tmshlvck/lark-hw/out/lark.pdf

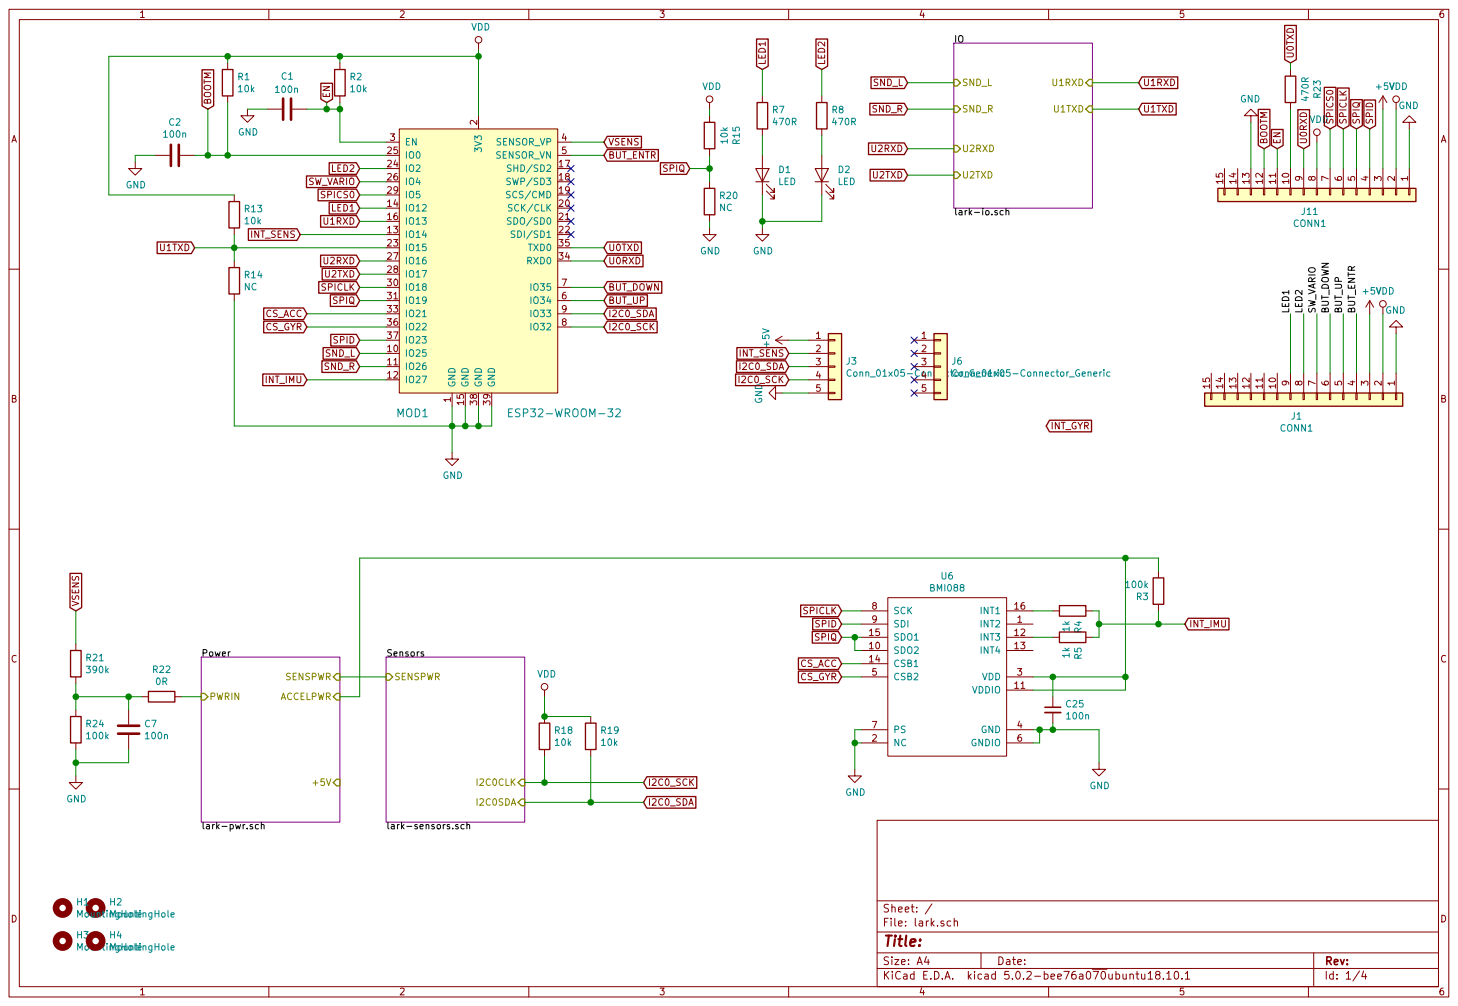
[picture p1: page 1]

2 SCK/CLK 20 SDO/SD0 21 SDI/SD1 22

Id: 1/4 Title: File: lark.sch Sheet: / GND

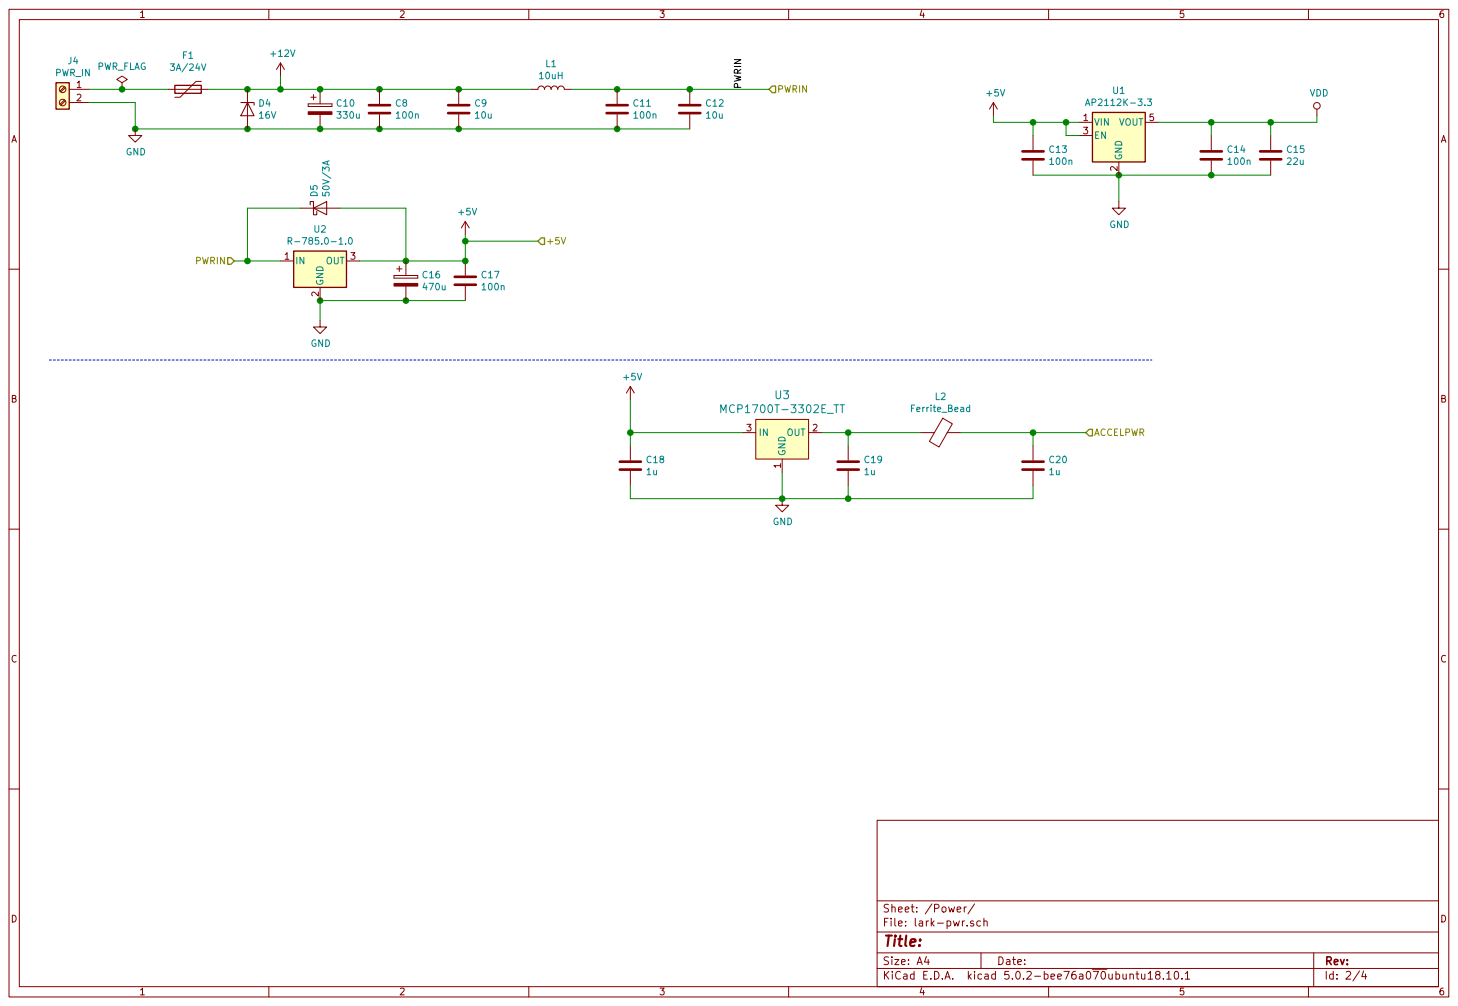
[picture p2: page 2]

File: lark-pwr.sch Sheet: /Power/
Id: 2/4 Title:

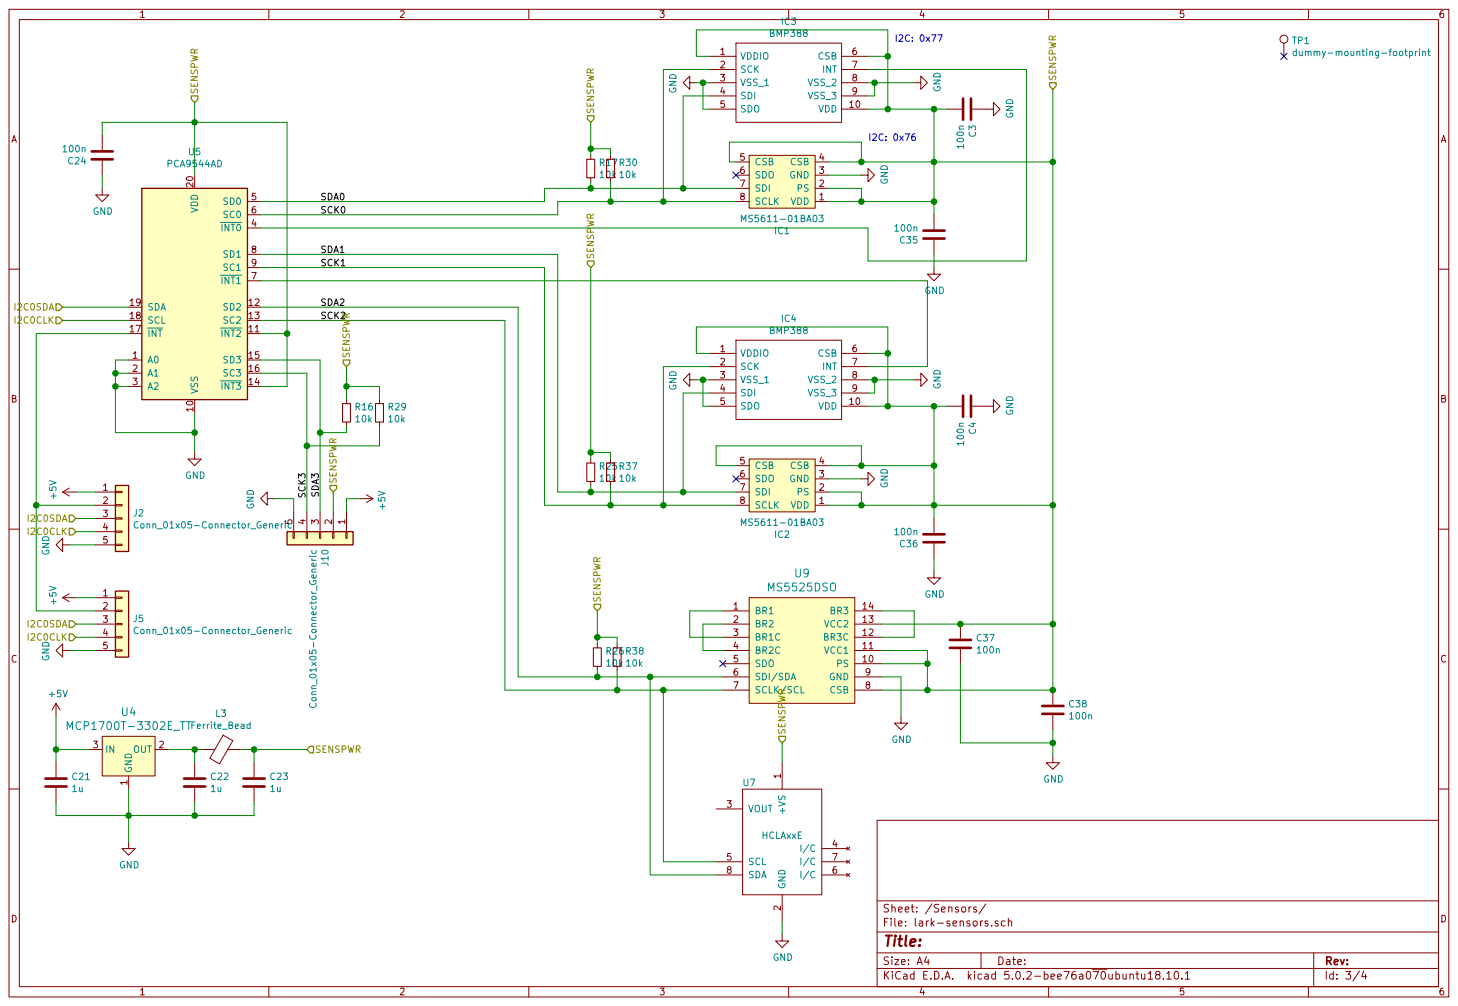
[picture p3: page 3]

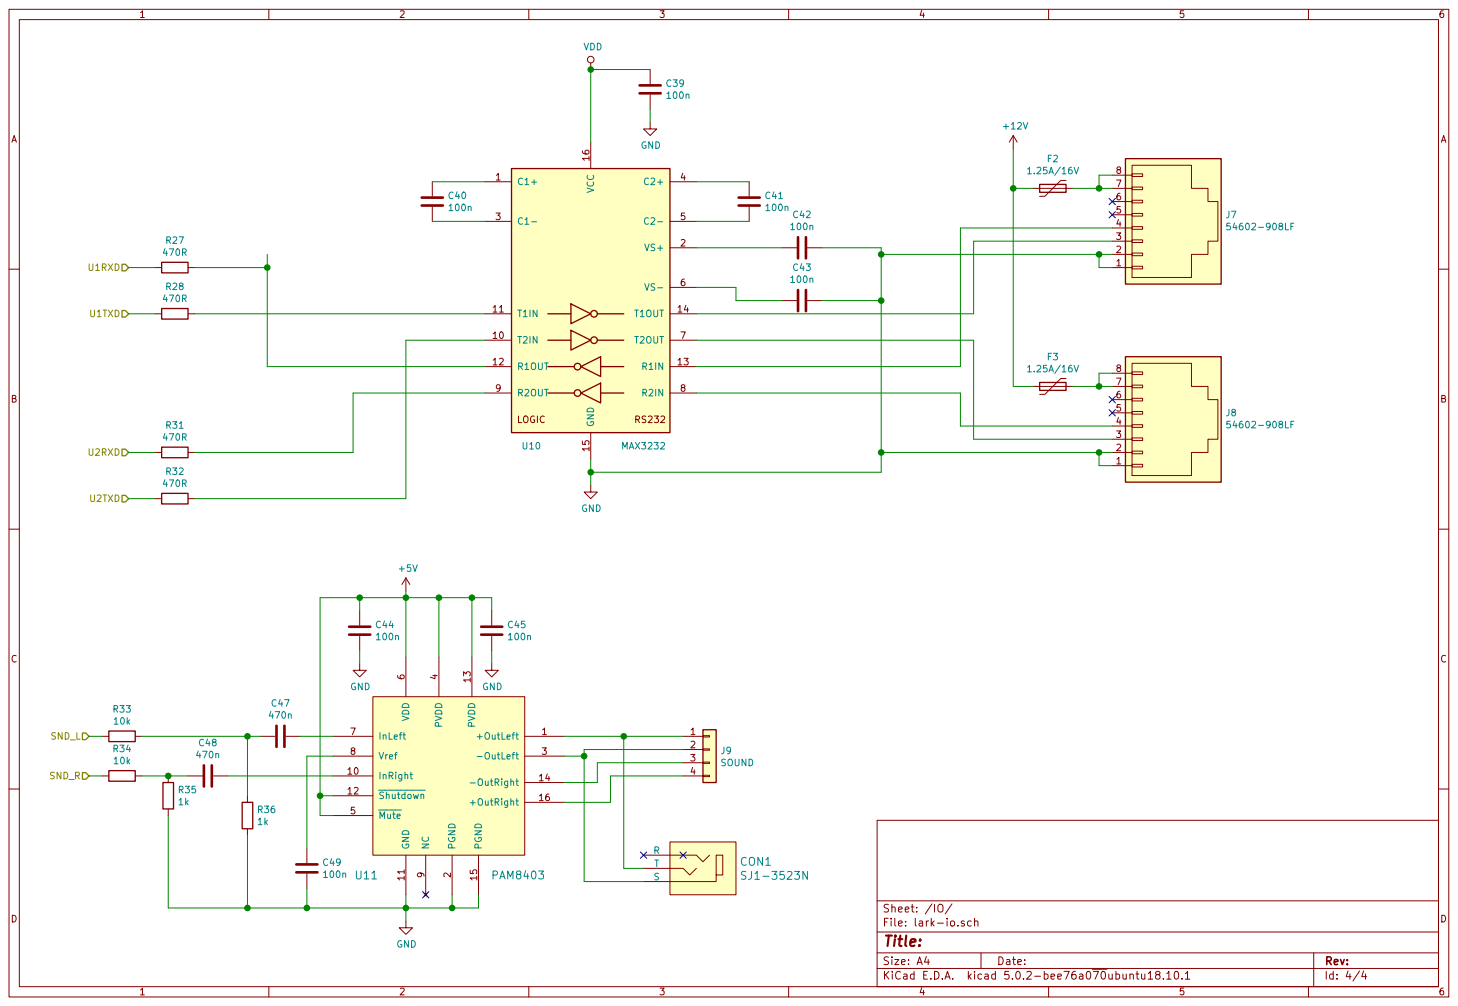
[picture p4: page 4]

Id: 4/4 Title: File: lark-io.sch Sheet: /IO/ SND_L SND_R
