tmshlvck/lark-hw/lark.kicad_pcb

## KiCad design lark.kicad_pcb (2019-03-14)

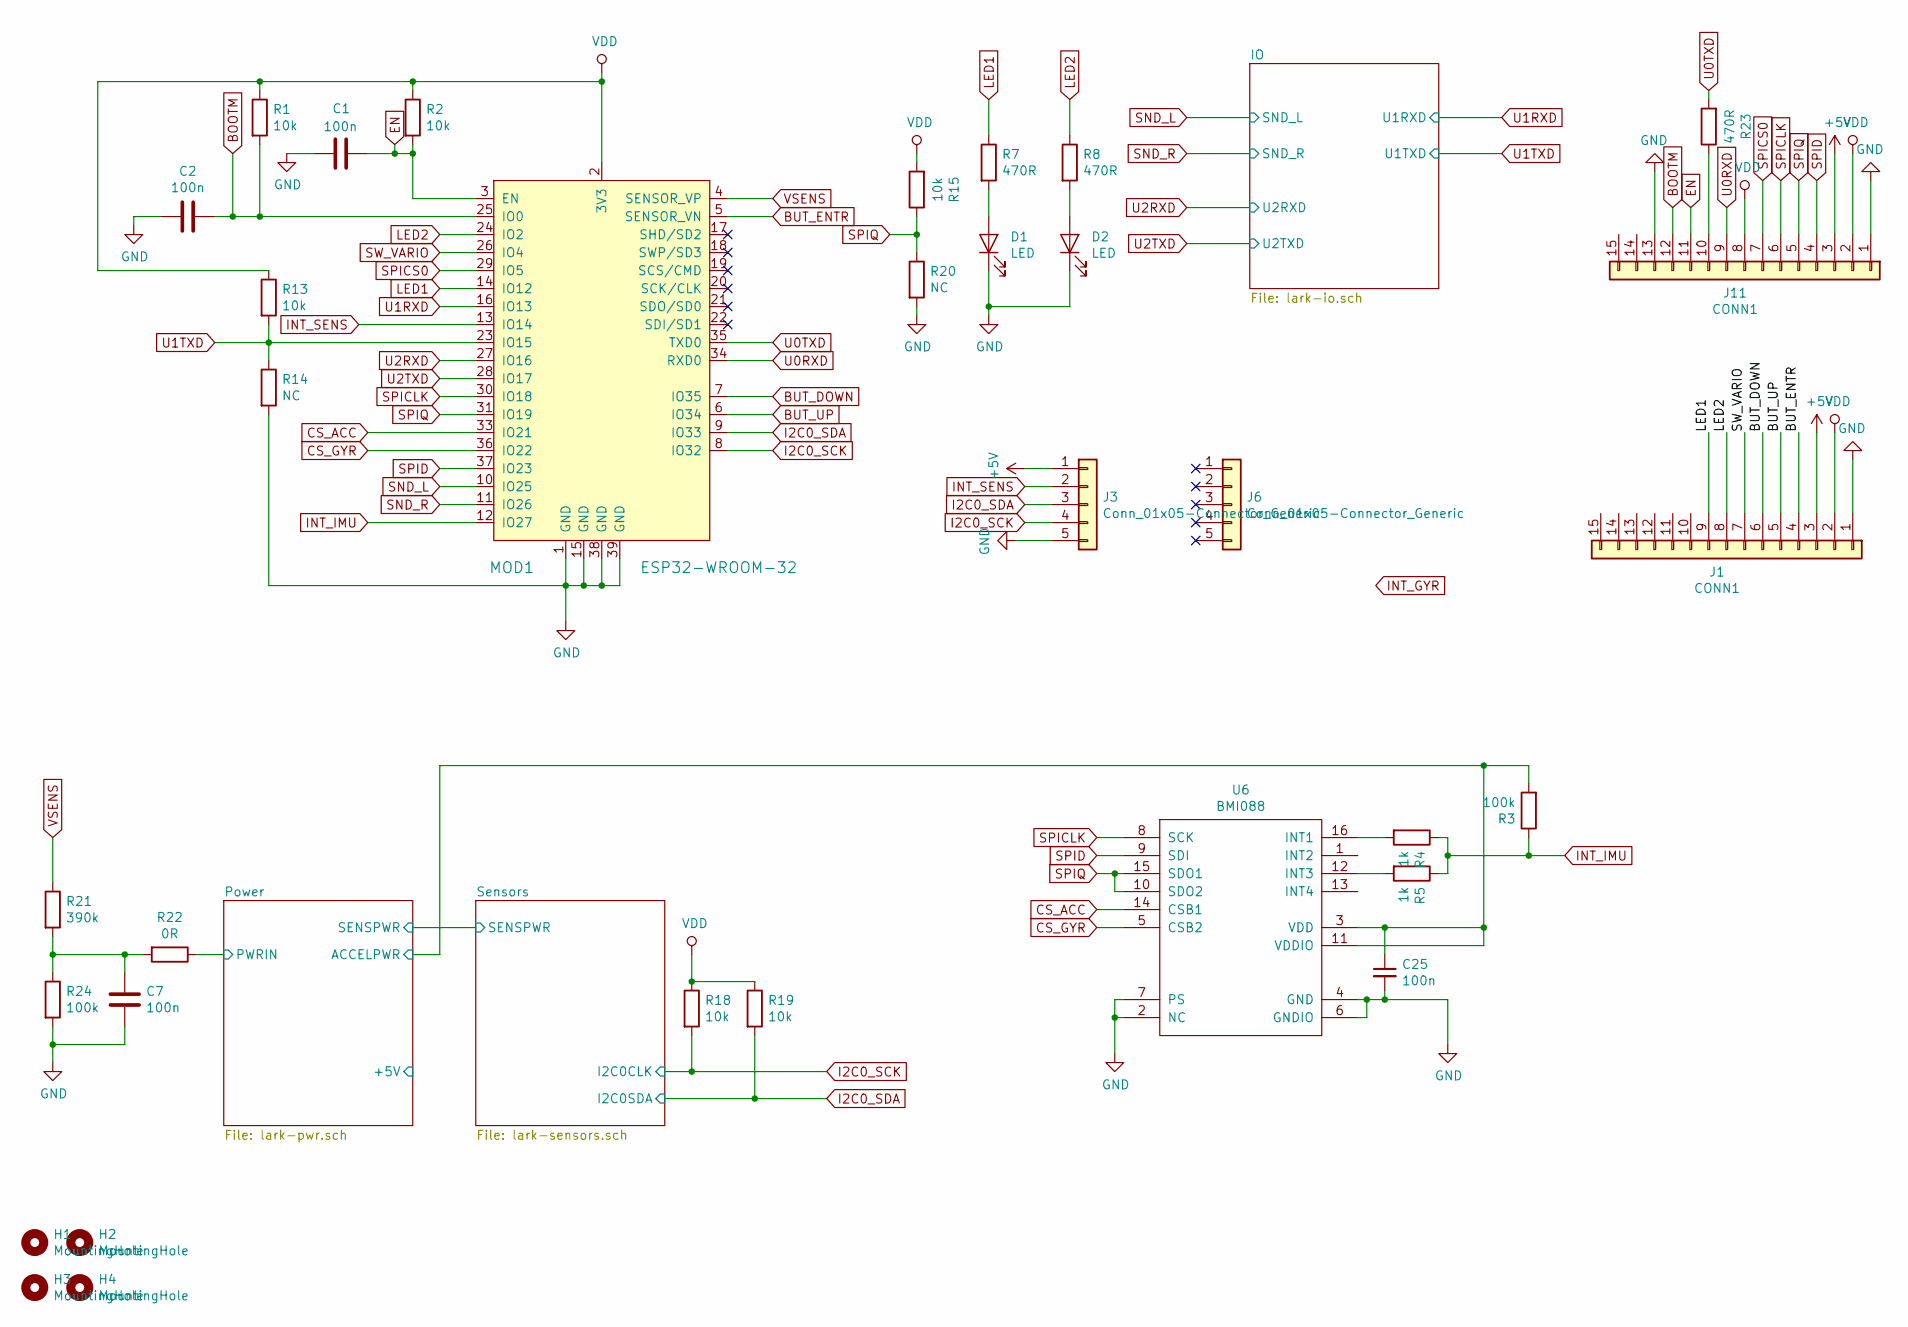
[picture p5: schematic lark.sch]

Parts:
C1, C2, C7: 100n; C_0805_2012Metric_Pad1.15x1.40mm_HandSolder; MPN 885012207128
C25: 100n; C_0805_2012Metric_Pad1.15x1.40mm_HandSolder
D1: LED; LED_1206_3216Metric_Pad1.42x1.75mm_HandSolder; MPN LTST-C150GKT
D2: LED; LED_1206_3216Metric_Pad1.42x1.75mm_HandSolder; MPN LTST-C150CKT
H1, H2, H3, H4: MountingHole; MountingHole_3.2mm_M3_DIN965
J1, J11: CONN1; PinHeader_1x15_P2.54mm_Vertical
J3, J6: Conn_01x05-Connector_Generic; PinHeader_1x05_P2.54mm_Vertical
MOD1: ESP32-WROOM-32; ESP32-WROOM-32D; MPN ESP32-WROOM-32; Digi-Key_PN 1904-1010-1-ND
R1, R2, R13, R15, R18, R19: 10k; R_0805_2012Metric_Pad1.15x1.40mm_HandSolder; MPN RC0805FR-0710KL
R3: 100k; R_0805_2012Metric_Pad1.15x1.40mm_HandSolder
R4, R5: 1k; R_0805_2012Metric_Pad1.15x1.40mm_HandSolder
R7, R8, R23: 470R; R_0805_2012Metric_Pad1.15x1.40mm_HandSolder; MPN RC0805FR-07470RL
R14, R20: NC; R_0805_2012Metric_Pad1.15x1.40mm_HandSolder
R21: 390k; R_0805_2012Metric_Pad1.15x1.40mm_HandSolder; MPN RT0805BRD07390KL
R22: 0R; R_0805_2012Metric_Pad1.15x1.40mm_HandSolder; MPN RC0805JR-070RL
R24: 100k; R_0805_2012Metric_Pad1.15x1.40mm_HandSolder; MPN RT0805BRD07100KL
U6: BMI088; LGA-16_handsolder

Connections:
+5V: J1.3, J3.1, J11.3; also elsewhere on the board
/Power/ACCELPWR: C25.1, R3.2, U6.3 (VDD), U6.11 (VDDIO); also elsewhere on the board
/Power/PWRIN: R22.1; also elsewhere on the board
BOOTM: C2.1, J11.12, MOD1.25 (IO0), R1.2
BUT_DOWN: J1.6, MOD1.7 (IO35)
BUT_ENTR: J1.4, MOD1.5 (SENSOR_VN)
BUT_UP: J1.5, MOD1.6 (IO34)
CS_ACC: MOD1.33 (IO21), U6.14 (CSB1)
CS_GYR: MOD1.36 (IO22), U6.5 (CSB2)
EN: C1.1, J11.11, MOD1.3 (EN), R2.2
GND: C1.2, C2.2, C7.2, C25.2, D1.1 (K), D2.1 (K), J1.1, J3.5, J11.1, J11.13, MOD1.1 (GND), MOD1.15 (GND), MOD1.38 (GND), MOD1.39 (GND), R14.2, R20.2, R24.2, U6.2 (NC), U6.4 (GND), U6.6 (GNDIO), U6.7 (PS); also elsewhere on the board
I2C0_SCK: J3.4, MOD1.8 (IO32), R18.2; also elsewhere on the board
I2C0_SDA: J3.3, MOD1.9 (IO33), R19.2; also elsewhere on the board
INT_IMU: MOD1.12 (IO27), R3.1, R4.1, R5.1
INT_SENS: J3.2, MOD1.13 (IO14)
LED1: J1.9, MOD1.14 (IO12), R7.1
LED2: J1.8, MOD1.24 (IO2), R8.1
unnamed: C7.1, R21.2, R22.2, R24.1
unnamed: D1.2 (A), R7.2
unnamed: D2.2 (A), R8.2
unnamed: J11.10, R23.1
unnamed: R4.2, U6.16 (INT1)
unnamed: R5.2, U6.12 (INT3)
SND_L: MOD1.10 (IO25); also elsewhere on the board
SND_R: MOD1.11 (IO26); also elsewhere on the board
SPICLK: J11.6, MOD1.30 (IO18), U6.8 (SCK)
SPICS0: J11.7, MOD1.29 (IO5)
SPID: J11.4, MOD1.37 (IO23), U6.9 (SDI)
SPIQ: J11.5, MOD1.31 (IO19), R15.1, R20.1, U6.10 (SDO2), U6.15 (SDO1)
SW_VARIO: J1.7, MOD1.26 (IO4)
U0RXD: J11.9, MOD1.34 (RXD0)
U0TXD: MOD1.35 (TXD0), R23.2
U1RXD: MOD1.16 (IO13); also elsewhere on the board
U1TXD: MOD1.23 (IO15), R13.2, R14.1; also elsewhere on the board
U2RXD: MOD1.27 (IO16); also elsewhere on the board
U2TXD: MOD1.28 (IO17); also elsewhere on the board
VDD: J1.2, J11.2, J11.8, MOD1.2 (3V3), R1.1, R2.1, R13.1, R15.2, R18.1, R19.1; also elsewhere on the board
VSENS: MOD1.4 (SENSOR_VP), R21.1

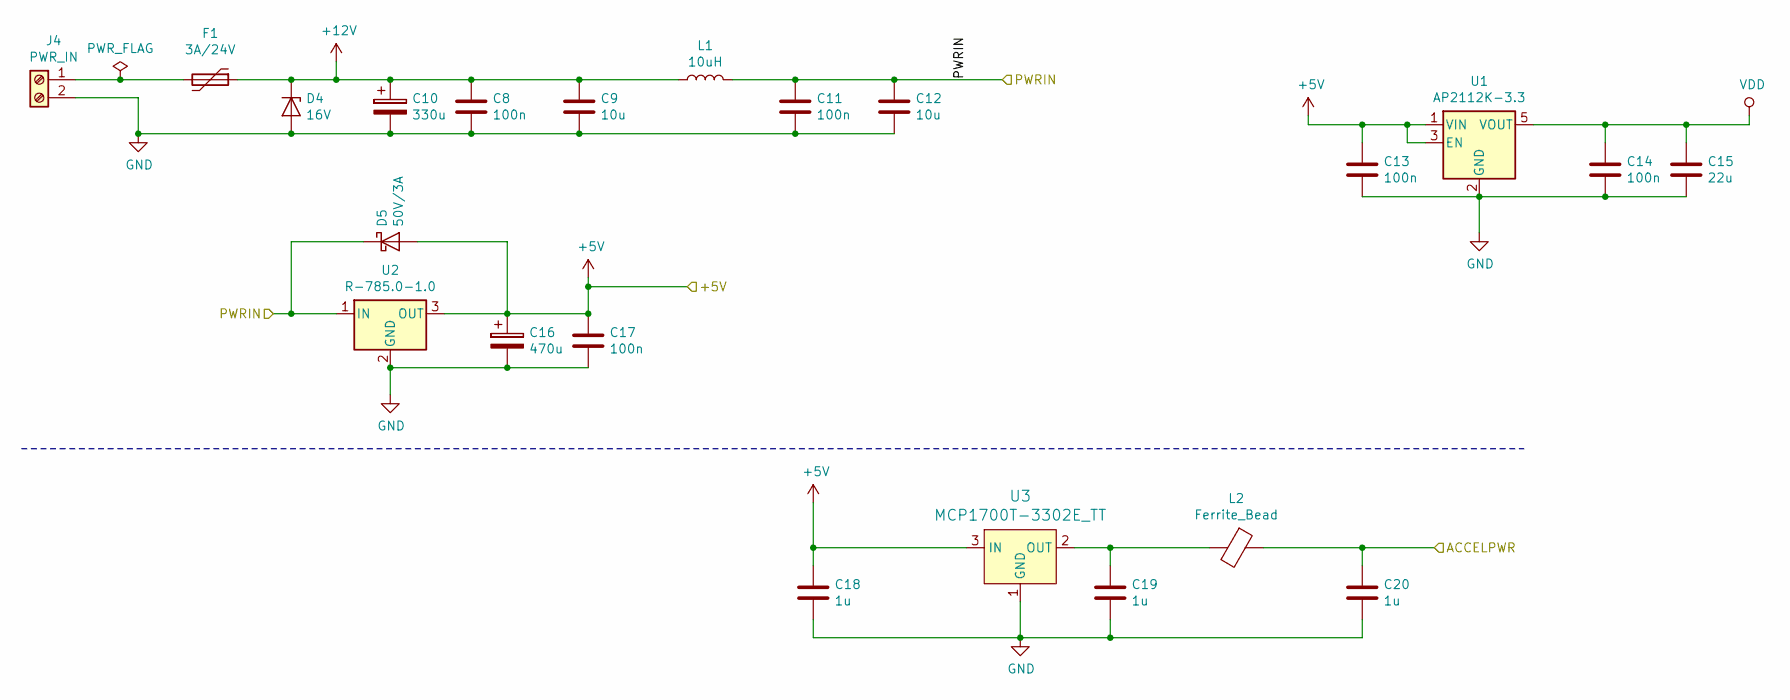
[picture p6: schematic lark-pwr.sch]

Parts:
C8, C11, C13, C14, C17: 100n; C_0805_2012Metric_Pad1.15x1.40mm_HandSolder; MPN 885012207128
C9, C12: 10u; C_0805_2012Metric_Pad1.15x1.40mm_HandSolder; MPN CL21B105KBFNNNG
C10: 330u; CP_Elec_10x10; MPN UUE1H331MNS1MS
C15: 22u; C_0805_2012Metric_Pad1.15x1.40mm_HandSolder; MPN GRM21BD70J226ME44L
C16: 470u; CP_Elec_10x10; MPN 493-16063-1-ND
C18, C19, C20: 1u; C_0805_2012Metric_Pad1.15x1.40mm_HandSolder; MPN CL21B105KBFNNNG
D4: 16V; D_SMA_Handsoldering; MPN SMBJ16A-TR
D5: 50V/3A; D_SMA_Handsoldering; MPN SK35
F1: 3A/24V; Fuse_1812_4532Metric_Pad1.30x3.40mm_HandSolder; MPN 0ZCF0300BF2C
J4: PWR_IN; TerminalBlock_Phoenix_PT-1,5-2-3.5-H_1x02_P3.50mm_Horizontal; MPN 277-1721-ND
L1: 10uH; L_Wuerth_WE-PD2-Typ-L
L2: Ferrite_Bead; L_0805_2012Metric_Pad1.15x1.40mm_HandSolder; MPN BLM21BD272SH1L
U1: AP2112K-3.3; SOT-23-5
U2: R-785.0-1.0; Converter_DCDC_RECOM_R-78E-0.5_THT
U3: MCP1700T-3302E_TT; SOT-23; MPN MCP1700T-3302E/TT; Digi-Key_PN MCP1700T3302ETTCT-ND

Connections:
+5V: C13.1, C16.1, C17.1, C18.1, D5.2 (A), U1.1 (VIN), U1.3 (EN), U2.3 (OUT), U3.3 (IN); also elsewhere on the board
+12V: C8.1, C9.1, C10.1, D4.1 (K), F1.1, L1.1; also elsewhere on the board
/Power/ACCELPWR: C20.1, L2.1; also elsewhere on the board
/Power/PWRIN: C11.1, C12.1, D5.1 (K), L1.2, U2.1 (IN); also elsewhere on the board
GND: C8.2, C9.2, C10.2, C11.2, C12.2, C13.2, C14.2, C15.2, C16.2, C17.2, C18.2, C19.2, C20.2, D4.2 (A), J4.2, U1.2 (GND), U2.2 (GND), U3.1 (GND); also elsewhere on the board
unnamed: C19.1, L2.2, U3.2 (OUT)
unnamed: F1.2, J4.1
VDD: C14.1, C15.1, U1.5 (VOUT); also elsewhere on the board

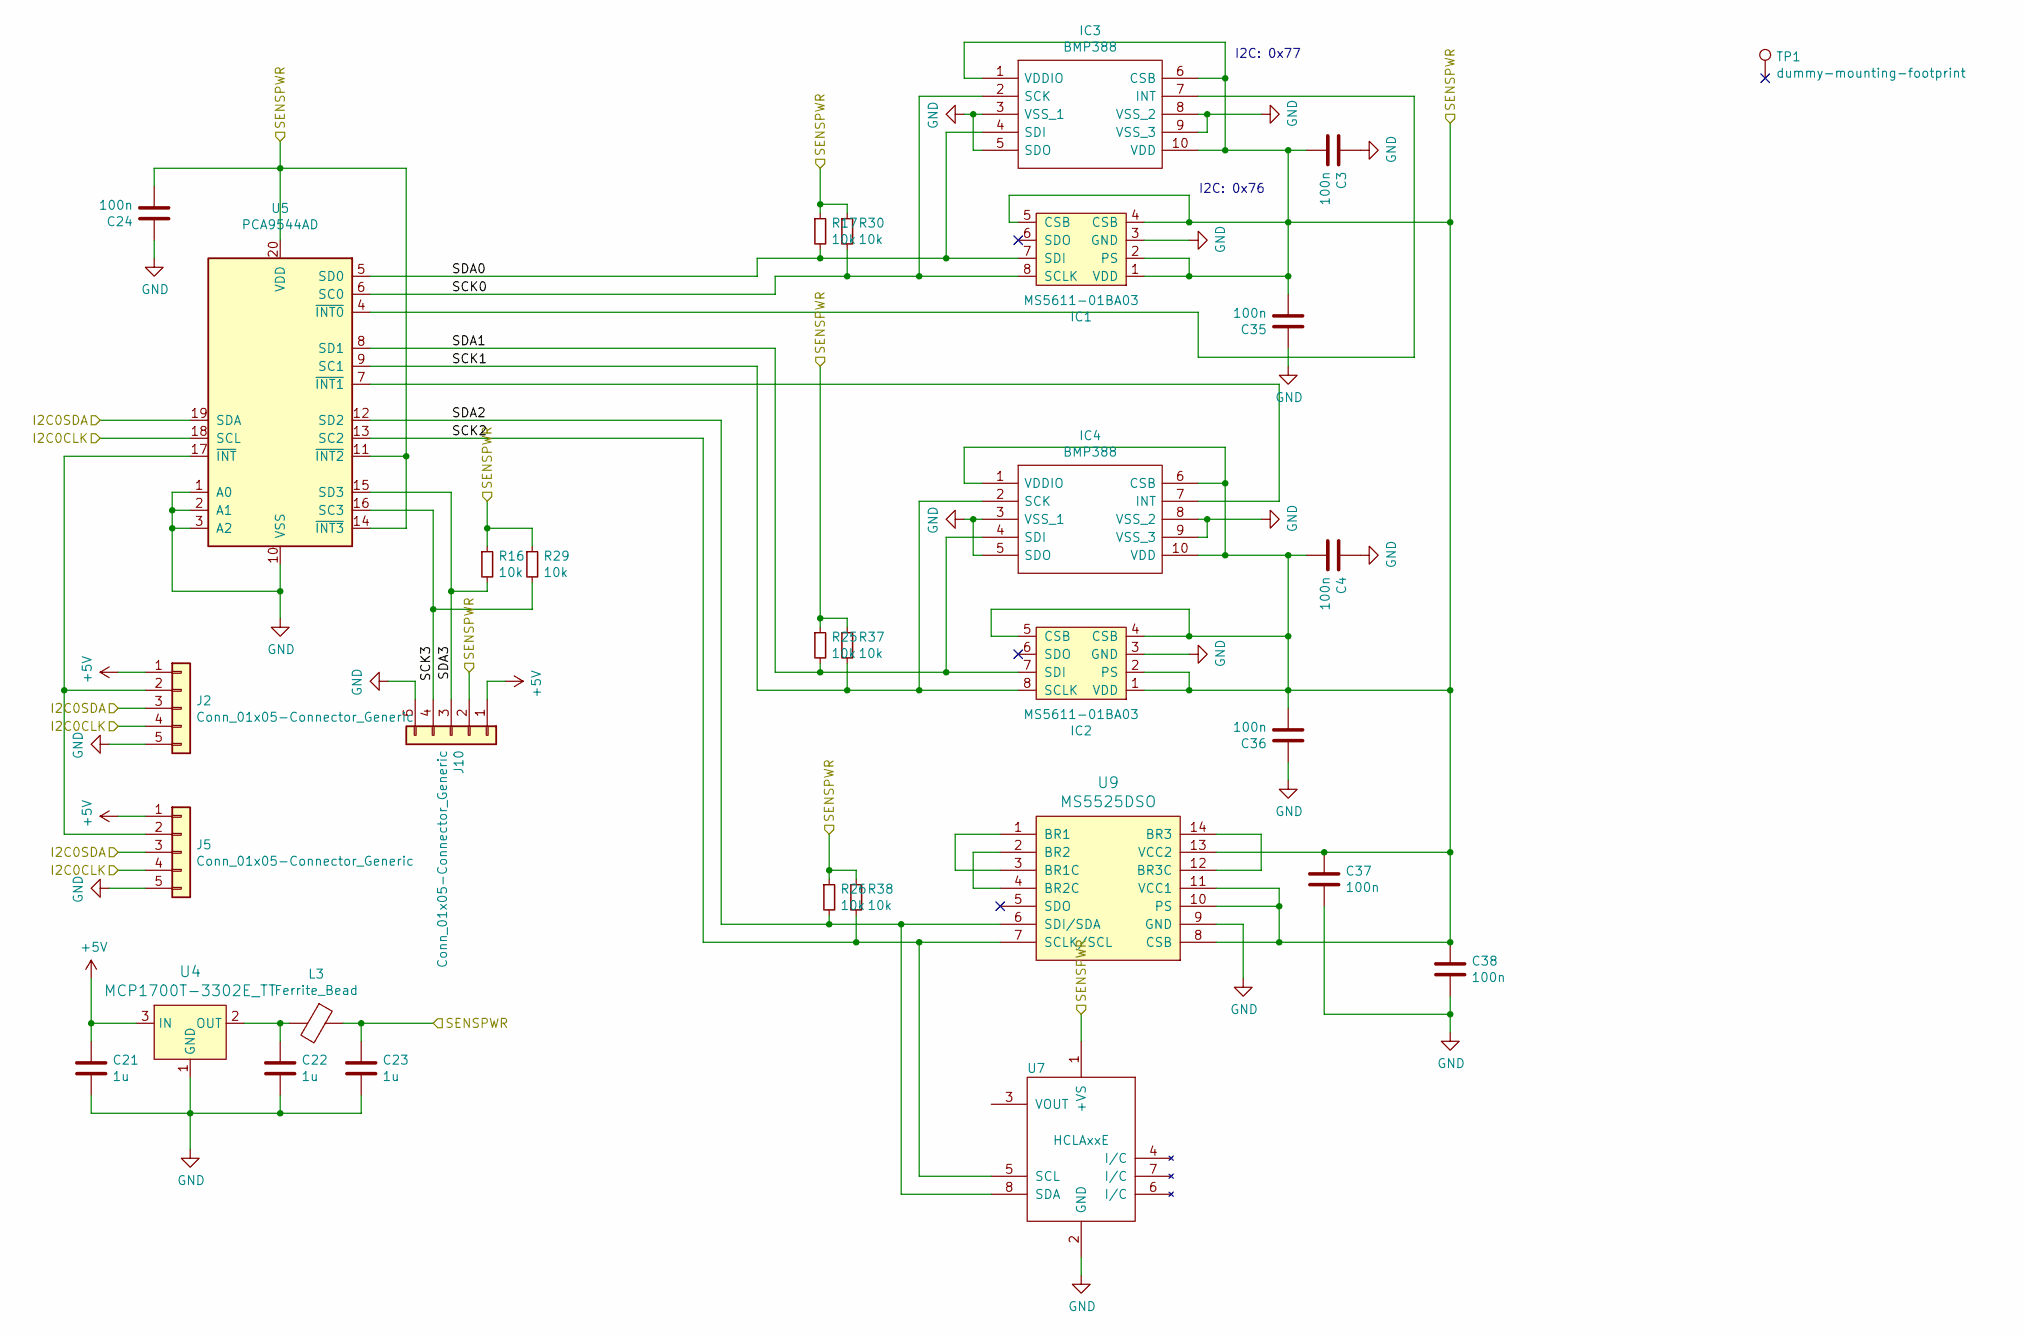
[picture p7: schematic lark-sensors.sch]

Parts:
C3, C4: 100n; C_0603_1608Metric; MPN 885012207128
C21, C22, C23: 1u; C_0805_2012Metric_Pad1.15x1.40mm_HandSolder; MPN CL21B105KBFNNNG
C24, C35, C36, C37, C38: 100n; C_0805_2012Metric_Pad1.15x1.40mm_HandSolder; MPN 885012207128
IC1, IC2: MS5611-01BA03; LGA-8_3x5mm_P1.25mm_handsolder; MPN MS561101BA03-50; Farnell 2362662
IC3, IC4: BMP388; LGA-10_2.0x2.0x0.75_handsolder; Manufacturer_Part_Number BMP388; Mouser Part Number 262-BMP388
J2, J5, J10: Conn_01x05-Connector_Generic; PinHeader_1x05_P2.54mm_Vertical
L3: Ferrite_Bead; L_0805_2012Metric_Pad1.15x1.40mm_HandSolder; MPN BLM21BD272SH1L
R16, R17, R25, R26, R29, R30, R37, R38: 10k; R_0805_2012Metric_Pad1.15x1.40mm_HandSolder
TP1: dummy-mounting-footprint; lark_sensor_mount
U4: MCP1700T-3302E_TT; SOT-23; MPN MCP1700T-3302E/TT; Digi-Key_PN MCP1700T3302ETTCT-ND
U5: PCA9544AD; SOIC-20W_7.5x12.8mm_P1.27mm
U7: HCLAxxE
U9: MS5525DSO; SOIC-14W_7.5x9.0mm_P1.27mm; MPN 5525DSO-DB001DS

Connections:
+5V: C21.1, J2.1, J5.1, J10.1, U4.3 (IN); also elsewhere on the board
/Sensors/SCK0: IC1.8 (SCLK), IC3.2 (SCK), R30.2, U5.6 (SC0)
/Sensors/SCK1: IC2.8 (SCLK), IC4.2 (SCK), R37.2, U5.9 (SC1)
/Sensors/SCK2: R38.2, U5.13 (SC2), U7.5 (SCL), U9.7 (SCLK/SCL)
/Sensors/SCK3: J10.4, R29.2, U5.16 (SC3)
/Sensors/SDA0: IC1.7 (SDI), IC3.4 (SDI), R17.2, U5.5 (SD0)
/Sensors/SDA1: IC2.7 (SDI), IC4.4 (SDI), R25.2, U5.8 (SD1)
/Sensors/SDA2: R26.2, U5.12 (SD2), U7.8 (SDA), U9.6 (SDI/SDA)
/Sensors/SDA3: J10.3, R16.2, U5.15 (SD3)
/Sensors/SENSPWR: C3.2, C4.2, C23.1, C24.2, C35.2, C36.2, C37.1, C38.1, IC1.1 (VDD), IC1.2 (PS), IC1.4 (CSB), IC1.5 (CSB), IC2.1 (VDD), IC2.2 (PS), IC2.4 (CSB), IC2.5 (CSB), IC3.1 (VDDIO), IC3.6 (CSB), IC3.10 (VDD), IC4.1 (VDDIO), IC4.6 (CSB), IC4.10 (VDD), J10.2, L3.1, R16.1, R17.1, R25.1, R26.1, R29.1, R30.1, R37.1, R38.1, U5.11 (~INT2), U5.14 (~INT3), U5.20 (VDD), U7.1 (+VS), U9.8 (CSB), U9.10 (PS), U9.11 (VCC1), U9.13 (VCC2)
GND: C3.1, C4.1, C21.2, C22.2, C23.2, C24.1, C35.1, C36.1, C37.2, C38.2, IC1.3 (GND), IC2.3 (GND), IC3.3 (VSS_1), IC3.5 (SDO), IC3.8 (VSS_2), IC3.9 (VSS_3), IC4.3 (VSS_1), IC4.5 (SDO), IC4.8 (VSS_2), IC4.9 (VSS_3), J2.5, J5.5, J10.5, U4.1 (GND), U5.1 (A0), U5.2 (A1), U5.3 (A2), U5.10 (VSS), U7.2 (GND), U9.9 (GND); also elsewhere on the board
I2C0_SCK: J2.4, J5.4, U5.18 (SCL); also elsewhere on the board
I2C0_SDA: J2.3, J5.3, U5.19 (SDA); also elsewhere on the board
unnamed: C22.1, L3.2, U4.2 (OUT)
unnamed: IC3.7 (INT), U5.4 (~INT0)
unnamed: IC4.7 (INT), U5.7 (~INT1)
unnamed: J2.2, J5.2, U5.17 (~INT)
unnamed: U9.1 (BR1), U9.3 (BR1C)
unnamed: U9.2 (BR2), U9.4 (BR2C)
unnamed: U9.12 (BR3C), U9.14 (BR3)

Notes on the sheet:
I2C: 0x77
I2C: 0x76

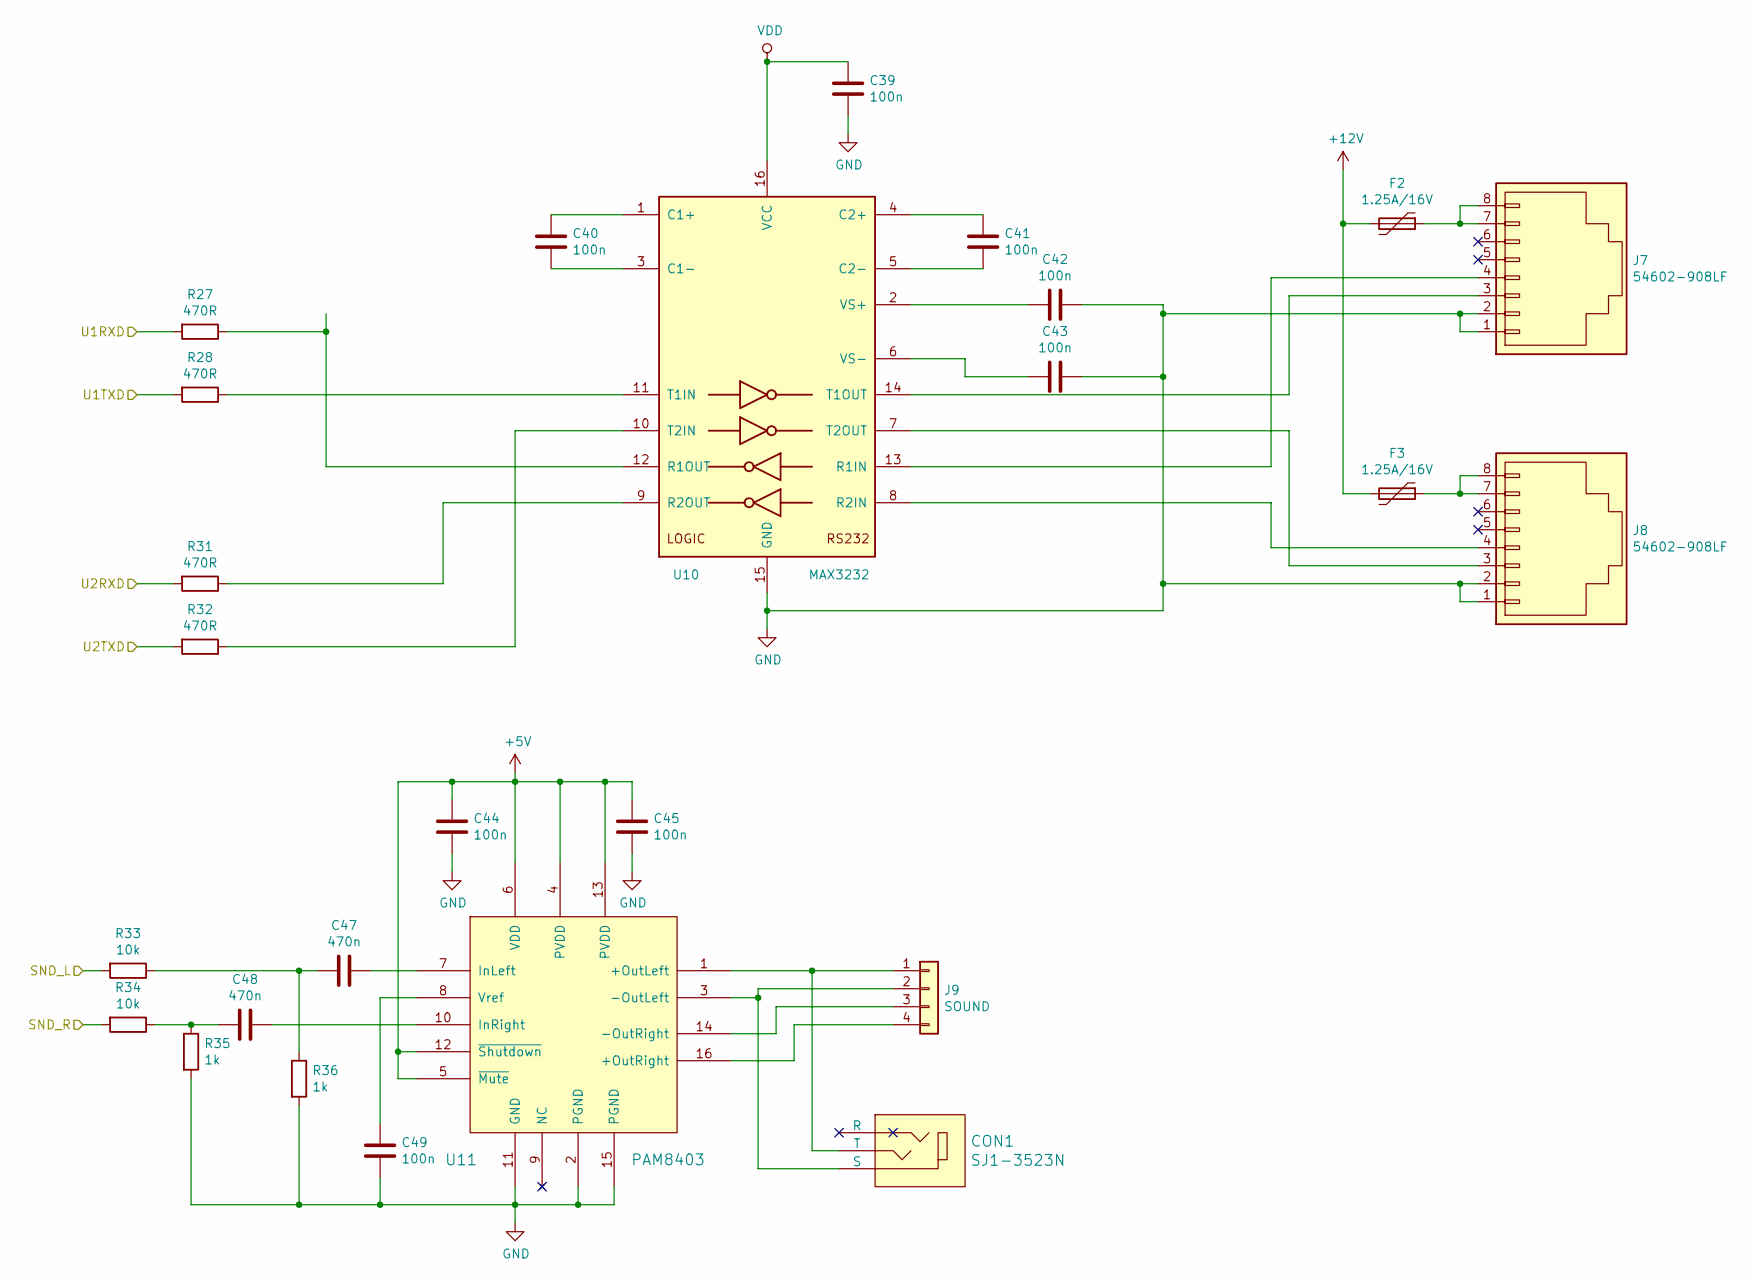
[picture p8: schematic lark-io.sch]

Parts:
C39, C40, C41, C42, C43, C44, C45, C49: 100n; C_0805_2012Metric_Pad1.15x1.40mm_HandSolder; MPN 885012207128
C47, C48: 470n; C_0805_2012Metric_Pad1.15x1.40mm_HandSolder; MPN 885012207102
CON1: SJ1-3523N; Headphone_Jack_2.5mm_SJ1-3523N; MPN SJ1-3523N; Digi-Key_PN CP1-3523N-ND
F2, F3: 1.25A/16V; Fuse_1812_4532Metric_Pad1.30x3.40mm_HandSolder; MPN 1812L125/16DR
J7, J8: 54602-908LF; 634108185521; MPN 54602-908LF; Digi-Key_PN 609-1046-ND
J9: SOUND; PinHeader_1x04_P2.54mm_Vertical
R27, R28, R31, R32: 470R; R_0805_2012Metric_Pad1.15x1.40mm_HandSolder; MPN RC0805FR-07470RL
R33, R34: 10k; R_0805_2012Metric_Pad1.15x1.40mm_HandSolder; MPN RC0805FR-0710KL
R35, R36: 1k; R_0805_2012Metric_Pad1.15x1.40mm_HandSolder; MPN RC0805FR-071KL
U10: MAX3232; SOIC-16_3.9x9.9mm_P1.27mm; MPN MAX3232ECDR
U11: PAM8403; SOIC-16_3.9x9.9mm_P1.27mm; MPN PAM8403DR

Connections:
+5V: C44.1, C45.1, U11.4 (PVDD), U11.5 (~Mute), U11.6 (VDD), U11.12 (~Shutdown), U11.13 (PVDD); also elsewhere on the board
+12V: F2.2, F3.2; also elsewhere on the board
GND: C39.2, C42.1, C43.1, C44.2, C45.2, C49.2, J7.1, J7.2, J8.1, J8.2, R35.2, R36.2, U10.15 (GND), U11.2 (PGND), U11.11 (GND), U11.15 (PGND); also elsewhere on the board
unnamed: C40.1, U10.1 (C1+)
unnamed: C40.2, U10.3 (C1-)
unnamed: C41.1, U10.4 (C2+)
unnamed: C41.2, U10.5 (C2-)
unnamed: C42.2, U10.2 (VS+)
unnamed: C43.2, U10.6 (VS-)
unnamed: C47.1, U11.7 (InLeft)
unnamed: C47.2, R33.1, R36.1
unnamed: C48.1, U11.10 (InRight)
unnamed: C48.2, R34.1, R35.1
unnamed: C49.1, U11.8 (Vref)
unnamed: CON1.1 (S), J9.2, U11.3 (-OutLeft)
unnamed: CON1.2 (T), J9.1, U11.1 (+OutLeft)
unnamed: F2.1, J7.7, J7.8
unnamed: F3.1, J8.7, J8.8
unnamed: J7.3, U10.14 (T1OUT)
unnamed: J7.4, U10.13 (R1IN)
unnamed: J8.3, U10.7 (T2OUT)
unnamed: J8.4, U10.8 (R2IN)
unnamed: J9.3, U11.14 (-OutRight)
unnamed: J9.4, U11.16 (+OutRight)
unnamed: R27.1, U10.12 (R1OUT)
unnamed: R28.1, U10.11 (T1IN)
unnamed: R31.1, U10.9 (R2OUT)
unnamed: R32.1, U10.10 (T2IN)
SND_L: R33.2; also elsewhere on the board
SND_R: R34.2; also elsewhere on the board
U1RXD: R27.2; also elsewhere on the board
U1TXD: R28.2; also elsewhere on the board
U2RXD: R31.2; also elsewhere on the board
U2TXD: R32.2; also elsewhere on the board
VDD: C39.1, U10.16 (VCC); also elsewhere on the board

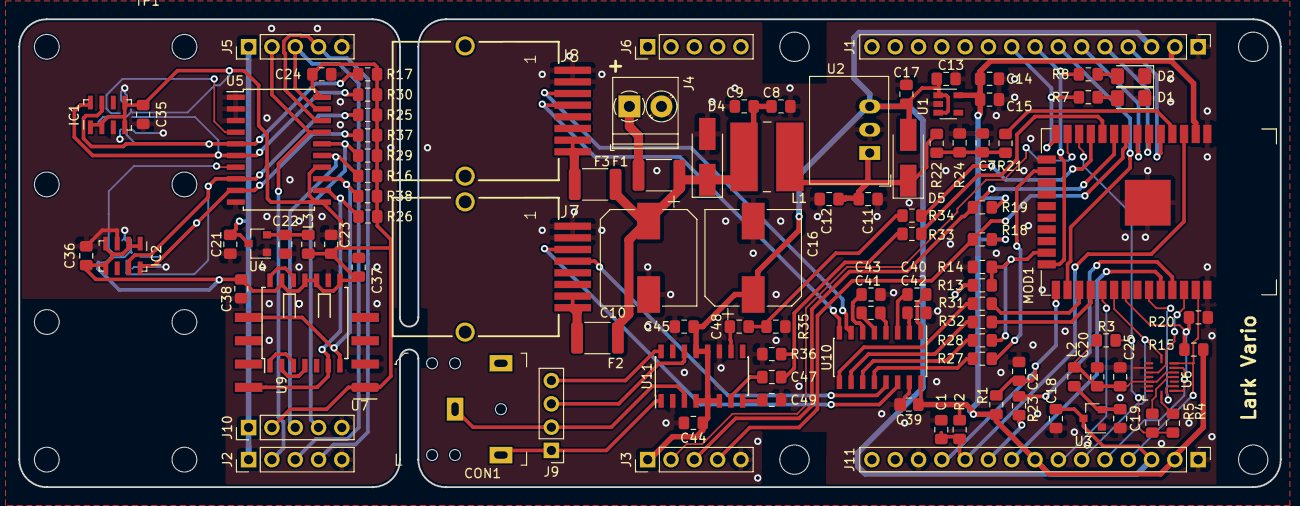
[picture p9: board lark.kicad_pcb from above]

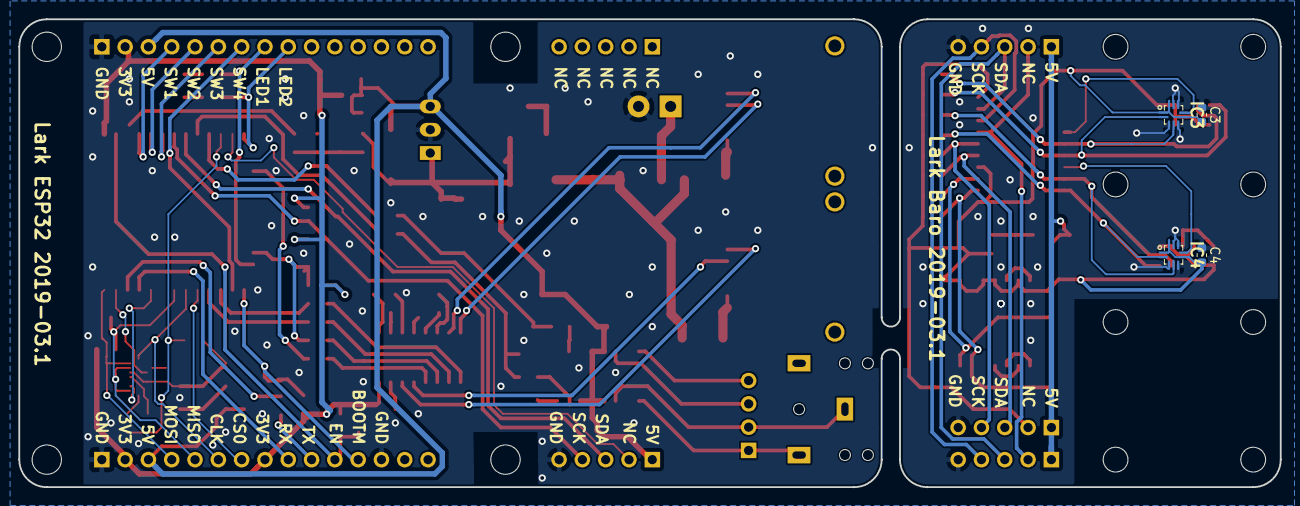
[picture p10: board lark.kicad_pcb from below]

Board: 2 copper layers, 137.5 x 51.0 mm, 112 parts (4 on the bottom side), 82 nets.
