tmshlvck/lark-hw/(commit log)

2018-01-24 Add first version of schematic
    Add first version of the schematic.
    TODOs:
    Select passive parts
    Verify digital interconnects
    Review power supplies
    Review decoupling, EMI-relevant parts...
    Review overall design
    [lark-power.sch, lark-sensors.sch, lark.sch]
2018-01-24 Remove orphan GPS PPS signal
    Remove orphan.
    Give up on GPS PPS feed. Not enough pins.
    [lark.sch]
2018-03-23 Finalize schematics and component selection
    Remove SD interface
    Rework power supplies
    [lark-power.sch, lark-sensors.sch, lark.sch]
2019-02-03 Rework the schematic from scratch
    Rework basic ESP32 pin assignment
    Rework power supply
    Rework interface
    Rework sound generation - remove I2C codec, use internal DAC
    Add D-class amplifier
    Add Serial lines
    Add USB charger
    [lark-io.sch, lark-power.sch, lark-pwr.sch, lark-sensors.sch, lark.kicad_pcb, lark.sch]
2019-02-08 Finalize schematic
    Finish part selection
    Pending issues: IMU, switches & LEDs, mechanical parts and housing
    selection.
    [lark-io.sch, lark-pwr.sch, lark-sensors.sch, lark.sch]
2019-02-15 Prepare symbol for BMX055
    MPU-9250 is being phased out... We need a replacement IMU.
2019-02-16 Replace MPU-9250 IMU with BMX055
    [lark-io.sch, lark-sensors.sch]
2019-02-16 Fix TPS2511 thermal pad number
    PAD is pin 9.
2019-02-16 Fill in all remaining PNs in the schematics
    Finish the part selection, let's hope for least possible number of mistakes.
    [lark-pwr.sch, lark.sch]
2019-02-20 Add initial layout of the board.
    Think over the placement of the parts and perhaps reduce unnecessary capacitors in the power supplies.
    [lark.kicad_pcb]
2019-03-10 Intermediate status while arranging compontents.
    Manually grouped components into smaller islands.
    Some parts were changed:
    * U1: SOT-23-3 LDO should be sufficient
    * CP_Elec: Use 10x10 size
    [lark-io.sch, lark-pwr.sch, lark-sensors.sch, lark.kicad_pcb, lark.sch]
2019-03-14 continue layout work, WIP
    [lark-io.sch, lark-pwr.sch, lark-sensors.sch, lark.kicad_pcb, lark.sch]
2019-03-14 Updating schematic for the first prototype
    * U1 can supply up to 600 mA
    * drop USB charger for now
    * smaller type of DC/DC (U2) for input
    * remove one of the large capacitors
    * change BMX interface to 4-wire SPI for speed reasons
    * add I2C mux for pressure sensors
    The changes were made during the meeting with Tomas.
    BMX055 will be replaced by BMX088. For mechanical reasons, the pressure
    sensors will be placed on a daughterboard. The daughterboard could get
    footprints for different kinds pressure sensors (i.e. BMP388, HCLA0025).
    [lark-io.sch, lark-pwr.sch, lark-sensors.sch, lark.kicad_pcb, lark.sch]
2019-03-14 Use BMI088 instead of BMX055.
    Symbol for BMI088 was created and placed in the schematic.
    Still looking for a LGA-16 4.5x3.0 footprint. Do we really need to
    create that ourselves?
    [lark-io.sch, lark-pwr.sch, lark-sensors.sch, lark.kicad_pcb, lark.sch]
2019-03-14 Fitting layout into 57 mm instrument.
    * board width is 51 mm at the moment
    * split into two boards (sensor and main) which can be stacked with
    2.54 mm pinheaders.
    * ESP32 was put to bottom with optional pcb antenna facing to front.
    * added footprint for optional HCLAxxE on sensorboard
    * added footprint for BMI088
    * Is multiple GND pins for sensor board really a good idea (ground loops)?
    * Does the +12V topology make sense (especially regarding the external
    IGC ports)?
    [lark-io.sch, lark-pwr.sch, lark-sensors.sch, lark.kicad_pcb, lark.sch]
2019-03-14 lib: add LGA-10 footprint (for BMP388)
2019-03-14 Layout almost complete.
    [lark-sensors.sch, lark.kicad_pcb, lark.sch]
2019-03-14 even more finished
    [lark.kicad_pcb]
2019-03-14 fix some vias
    they were not shown correctly in the preview on aisler.net
    [lark.kicad_pcb]
2019-03-14 sensors.sch: connect INT pins of BMP388 to I2C mux.
    [lark-sensors.sch]
2019-03-14 connect BMI088 INT lines
    They will be set to open-drain mode, so one interrupt pin on the ESP32
    can be used for both.
    [lark.sch]
2019-03-14 variant of MS5611 footprint for easier handsoldering
2019-03-14 connect SENS_INT and IMU_INT to ESP
    [lark.sch]
2019-03-14 update layout
    IRQs connected
    somehow handsoldering friendly BS5611
    DRC is OK.
    Unconnected: 5 nets (will later connect the sensor board)
    [lark-sensors.sch, lark.kicad_pcb]
2019-03-14 Plot schematic and save in out
    Plot the prototype schematic and save in out directory.
